JinkyoJB/SCARA/sw/README.md

# sw

제어 소프트웨어. 구조·파이프라인·도구 설명은 [../docs/software.md](../docs/software.md).

```bash
python sw/main.py
```
