JinkyoJB/SCARA/sw/tools/README.md

# tools

진단 도구. 각 도구의 용도는 [../../docs/software.md](../../docs/software.md) 참조.
일상 제어는 `python sw/main.py`.
