JinkyoJB/SCARA/HW/hw_step_files/RFpiller.STEP

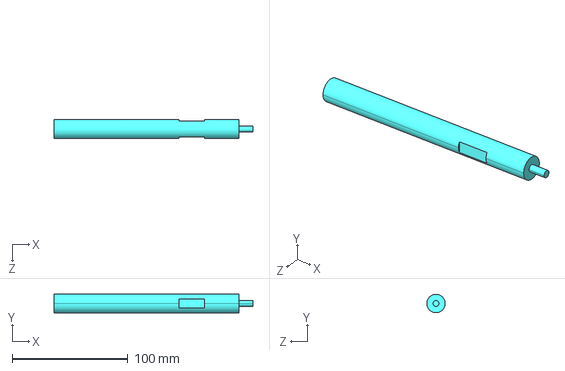
[picture p3: CAD file, 2026-09-02]
HW/hw_step_files/RFpiller.STEP
172.0 x 16.0 x 16.0 mm
