JinkyoJB/SCARA/HW/HWscar-V2.step

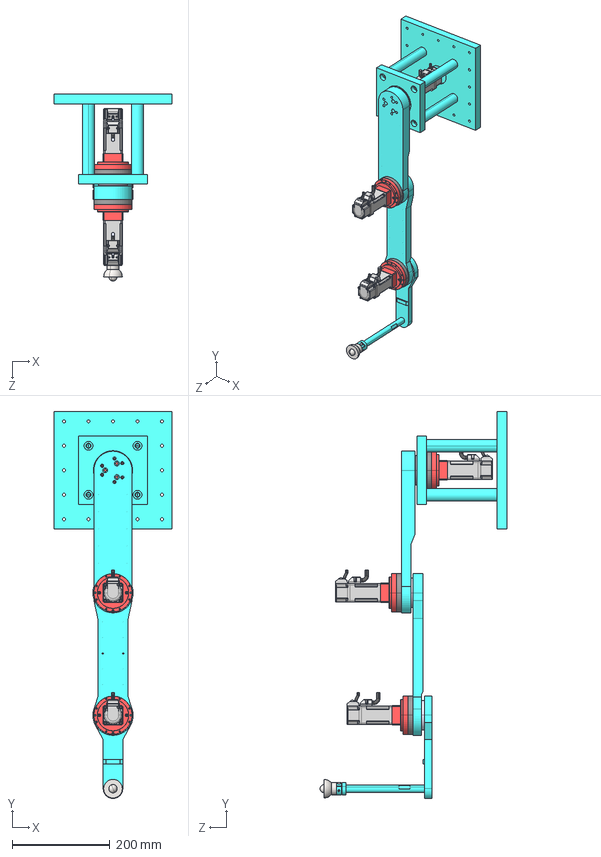
[picture p4: CAD file, 2026-09-02]
HW/HWscar-V2.step
240.0 x 790.0 x 381.7 mm
R01-PQ003-C2 x 3
MSMF012L1S2 x 3
base AP
bar x 4
LzigTre_003_500
link-1
link-2
link-3
RFpiller
RFhold
RF
