JinkyoJB/SCARA/HW/HWscar-V2/HWscar-V2.1.obj

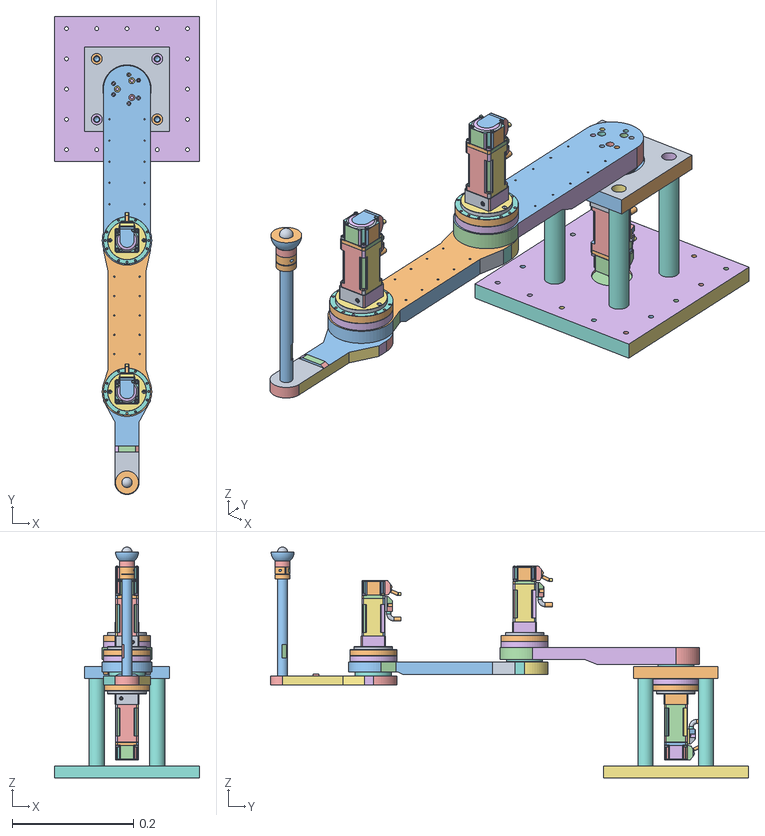
[picture p5: CAD file, 2026-09-02]
HW/HWscar-V2/HWscar-V2.1.obj
0.24 x 0.79 x 0.382
