JinkyoJB/SCARA/HW/hw_step_files/link-3.STEP

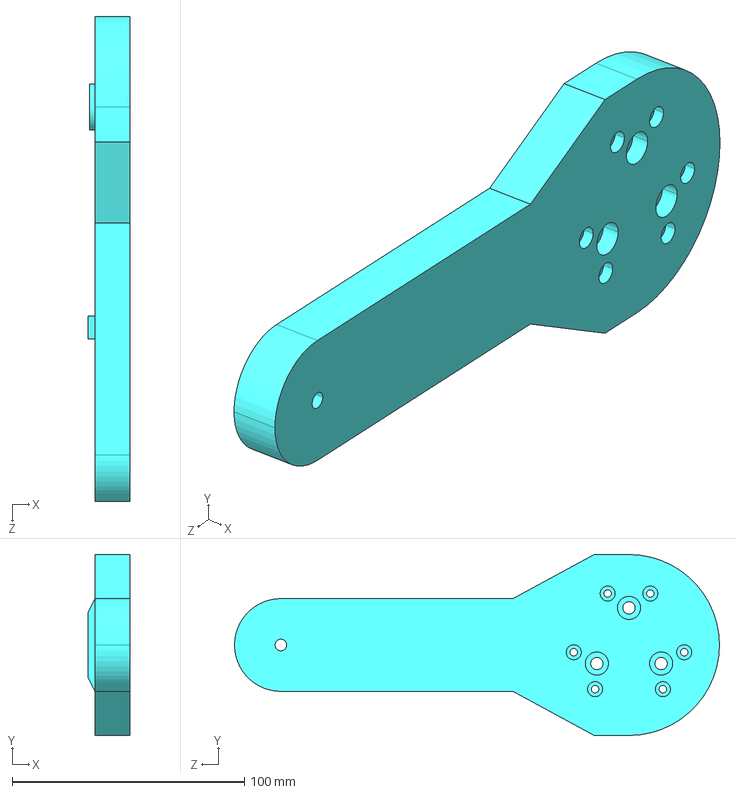
[picture p9: CAD file, 2026-09-02]
HW/hw_step_files/link-3.STEP
18.0 x 78.0 x 209.0 mm
