JinkyoJB/SCARA/HW/hw_step_files/RFhold.STEP

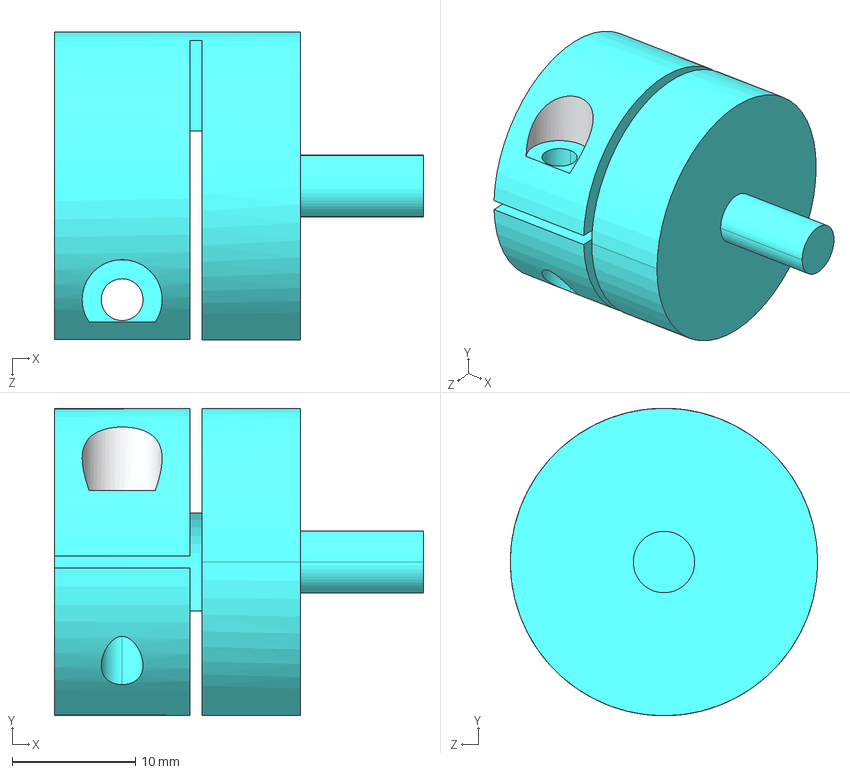
[picture p12: CAD file, 2026-09-02]
HW/hw_step_files/RFhold.STEP
30.0 x 25.0 x 25.0 mm
