JinkyoJB/SCARA/HW/reducers/PQ003-M.yaml

sn: PQ003-M
type: HD
efficiency: 1
size: 3
reducing_ratio: 50.5

rated_torque: 28
ad_torque: 49
ave_torque: 38

rated_speed: 2020
max_input_speed: 6060
ave_input_speed: 2020

rated_service_life: 10000

two_mupf: False
flexsplineFixed: True

bearing_type: CRB
dp: 0.06754
C: 25000
C0: 37000
fw: 1.35
Mc: 57
