JinkyoJB/SCARA/(commit log)

2026-09-02 SCARA 3자유도 제어 소프트웨어
    StellaX 제어기 위에서 도는 응용 로직과 안전 계층.
    관절각뿐 아니라 EE 좌표로 제어하며, 클릭 UI 로 위치를 지정한다.
    - scara/: SCARA 클래스 + 기구학 / 안전 / CAD 자기충돌 / 동작 / RPC 래퍼
    - 모든 이동이 같은 파이프라인을 지난다:
    가동범위 -> 특이점 -> 자기충돌(경로 중간 포함) -> TCP 속도 상한 -> 공진 회피 가속
    - tools/: 모델 검증, 영점 반복정밀도, 충돌 지도, 설정 덤프, 좌표 CLI
    - tests/: 실기 없이 도는 검증 38개
    - docs/: 하드웨어 파라미터, 제어기 설정, 정합 절차, 실측 결과
    [DEFAULT_MOTOR.yaml, HWscar-V2.1.obj, HWscar-V2.step, LzigTre_003_500.STEP, RFhold.STEP, RFpiller.STEP, bar.STEP, base AP.STEP]
2026-09-02 가공도면 PDF 를 저장소에 포함
    HW/hw_step_files/*.pdf 는 단품 가공도면이라 벤더 매뉴얼과 함께 제외돼 있었다.
    배포 제한이 없고 크기도 작으므로 포함한다.
2026-09-02 관절 한계를 자기충돌 안전 박스까지 확장
    컨트롤러 실측 조회 결과 Designer 설정은 J1 ±150 / J2 ±115 / J3 ±155 인데
    config 는 옛 값(±150/±95/±140)을 들고 있었다. 실제 값으로 맞춘다.
    소프트웨어 한계를 두 제약의 좁은 쪽으로 정의한다:
    - 컨트롤러 값 −1도 (폴트 대신 SafetyViolation 으로 거부하기 위한 완충)
    - 자기충돌 안전 박스 SELF_COLLISION_SAFE_BOX_DEG = (150, 110, 155)
    결과: J1 ±149 / J2 ±110 / J3 ±154.
    J2 는 충돌 박스가, J1·J3 는 컨트롤러 완충이 이긴다.
    안전 박스 경계는 실측 경계다. J3 를 156도로 한 칸 넓히면 최소 틈새가
    10.4 -> 8.0 mm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
